yufish87/LiDAR-based_Illegal_Parking_Detection_AMR/reference/navigation_investigation/README.md

# 室外導航調查的旁支快照

這五個檔案從原備份原樣複製，只供與六入口主流程比較；不是新增的正式啟動流程。`root_` 前綴表示來源是原 ntust 根目錄。`frames.gv` 的取得時間與背景未知。來源及 SHA-256 見 [複製清單](../../docs/copied_files_manifest.json)，分析見 [調查報告](../../docs/室外導航無法移動_調查報告.md)。
