yufish87/LiDAR-based_Illegal_Parking_Detection_AMR/docs/整理與檢查結果.md

# 整理與檢查結果

日期：2026-09-23。本次只準備本地 `github/` 目錄，未建立 Git repository、提交或上傳；原資料夾的程式與資源保留。

原車已拆除。此次另納入使用者說明的實車調校背景，以及點雲約 3.75 Hz、辨識平均高於 1 Hz 的歷史回憶；精確辨識值與量測日誌未留存。無法補測的項目改列歷史資料缺口，不要求以原車重測才能交付文件。

## 已完成

- 複製 2,694 個來源檔案（含 Mega sketch、尺寸原圖、室外導航調查的 5 個旁支快照及 IMU 查核的 3 個旁支檔案），涵蓋主控制、定位、光達、感知、禁停、相機、資源及報告。
- 新增 README、安裝／設定／驗證說明、依賴分組、來源與授權狀態、Git LFS 規則、Issue／PR 範本和手動靜態檢查流程。
- 已核對複製清單的來源與複本 SHA-256。相機部署網址外部化，以及架構／控制報告／缺漏文件更新為刻意變更；控制程式與新收錄韌體原樣保留。
- 32 個資源（含第三方測試資源）的 SHA-256 均通過；地圖、STL、權重、尺寸圖與前次 PDF 已在本地備妥。此次資訊更新以 Markdown 為準，未重製 PDF。
- 已新增使用者提供的辨識 YAML 與原廠硬體查核文件。前次已核對 12 項參數的結構、名稱、型別和值，以及當時 95 個文件本地連結；10 個主控制／辨識／韌體檔案的雜湊與來源一致。YAML 為單純數值與布林 mapping，採靜態格式核對，未在 ROS 執行載入。

## 靜態檢查結果

後續資訊更新已確認編碼器 1000 線、驅動器 1600 細分。文件補入 A 雙邊緣計數的條件式推算及 ppr=1600 待核對事項；此次另將使用者提供的辨識參數存為 config/vehicle_detector.yaml；未改動原控制／辨識程式預設、導航 YAML 或韌體，也未執行硬體測試。

檢查 612 個 Python、10 個 ROS package XML、1 個 URDF、8 個 console-script 入口、91 個 CMake 安裝程式路徑及 34 個 CUDA extension source 宣告。XML／URDF 解析及本次檢查涵蓋的 CMake／CUDA 檔案存在性檢查通過。

整體靜態檢查**未通過**，保留 5 項原始問題：辨識 launch 與 KITTI 評估工具各一處 Python 語法錯誤；兩個自製 ROS 入口及一個 SDK Python 入口找不到對應模組。詳見 [缺漏清單](檔案缺漏與待確認事項.md) 與 [機器可讀結果](static_audit.json)。沒有為取得成功狀態而隱藏這些問題。

使用者已確認 ROS 2 Foxy／Ubuntu 20.04，README 與安裝指引已改用該基線。主機已確認為 AGX Xavier，馬達型號已從原報告及原廠核對，14 mm 為輸出軸直徑；STL 原點為 O、圖右為 +x。現有 footprint 軸向不符已記錄，原廠配套驅動器手冊已找到但實車型號未確認。NDT 函式庫匯出、其他版本來源在 Foxy 的相容性、固定路徑和 TF／地圖一致性仍屬後續建置與部署核對事項，未被上述語法檢查證實通過或失敗。

## 未執行

目前在 Windows 進行檔案整理，沒有執行 Linux ROS／colcon 建置、shell 執行驗證、GPU 模型載入、Arduino 編譯／燒錄、Mega 通訊、相機上傳或實車導航。安裝文件是依原始碼及官方文件整理的操作指引，仍需在確定的 Jetson 環境完成驗證。

發布前必要補件見 [開源專案完整性清單](開源專案完整性清單.md)，收錄範圍見 [檔案收錄說明](檔案收錄說明.md)。

本輪文件更新已核對 110 個本地連結，更新三份複製文件的 SHA-256；兩套地圖 YAML／PGM 與 map.sh、nav1.sh 共六檔均與原來源雜湊一致。先前參數與程式檢查結果保留，未重跑 ROS 或硬體測試。

## 室外導航調查補充

新增 [調查報告](室外導航無法移動_調查報告.md) 與 [分析結果](navigation_investigation.json)。核對官方 Foxy 的地圖引數、QoS 參數覆寫、Map Server 發布與 StaticLayer 接收機制；完整解析兩張 PGM 與兩份 PCD 的 XYZ，資料列數均與 PCD header 相符。另確認主腳本所指 Ouster sensor.launch.xml 在目前備份未找到。控制程式、YAML、地圖及韌體未修改；所有根因結論保留歷史日誌與原安裝版本不足的限制。

本次最終核對 2,691 個複製檔案的雜湊與大小、125 個文件本地連結及 13 組主控制／地圖原檔與複本，均相符。另以官方 RewrittenYaml 的原始 helper 方法進行隔離執行，驗證代表性 StaticLayer mapping 會從 True 被覆寫為 False；未啟動 ROS 或 DDS。既有靜態程式檢查的 5 項問題保留。

## 啟動順序紀錄補充與判斷修正

已閱讀並核對 [fish/ros2_ws/run.md](../fish/ros2_ws/run.md)，其中 Nav2 → nav_gui → map.sh 的順序使「地圖先發布、導航後加入」缺乏直接支持，QoS 嫌疑已降為備選。README 先前自行排列的建議順序改為有來源的歷史順序；報告、架構、設定、缺漏與分析 JSON 已同步修正。使用者確認兩檔確實為不同場地的圖，此事不再僅列推測。原 run.md 與控制程式未修改。

此補充已驗證 run.md 的原檔、複本與既有清單雜湊相符，核對第 15／17／19 行順序；更新三份複製文件雜湊，檢查 137 個本地文件連結及七份啟動／設定檔的原檔與複本一致性，均通過。未重跑 ROS 或硬體測試。

## 2026-09-24 里程計與 IMU 查核

新增三題答覆與三份未修改的旁支參考，更新架構及缺漏說明。三份新複本均以原始位元組複製並登錄 SHA-256，兩份更新的複製文件已同步雜湊。既有 preparation_audit.json 保留前次檢查快照，本次未重跑完整檢查、ROS 或硬體測試。

## 2026-09-24 GitHub 資料夾完整性複查

- 已重新核對 2,694 個複製檔案的存在、大小及 SHA-256，並比對原備份來源；沒有漏複製、內容不符或重複目的地。
- 主控制入口、Mega 韌體、定位／光達套件、辨識／違停／相機程式、兩套 YAML／PGM、兩份 PCD、STL、權重、模型設定、zones 與實車辨識 YAML 均已收錄。
- README、安裝／設定／驗證、架構／硬體／報告、啟動紀錄、缺漏清單、來源與授權狀態、依賴分組及 GitHub 範本均存在。缺漏清單正式保留，README 已加入收錄狀態與限制說明。
- 重新執行既有靜態檢查及 32 個資源的 checksum 校驗；資源全數通過，程式仍有相同 5 項原始問題，沒有新增錯誤。
- 文件內本地連結檢查通過；未混入建置產物或巢狀 Git 目錄。完整數量與結果見 [preparation_audit.json](preparation_audit.json)。

可取得的主要備份已收錄；Ouster 確切部署入口、GAS 接收端及違停目標轉 Nav2 接收端等既有缺口仍明列。整體 LICENSE、來源／發布範圍與原機版本紀錄尚待確認，不能宣稱本資料夾已能直接完整重建。此次未修改控制程式、執行 ROS／硬體測試或上傳 GitHub。
