yufish87/LiDAR-based_Illegal_Parking_Detection_AMR/docs/檔案缺漏與待確認事項.md

# 檔案缺漏與待確認事項

最新更新：2026-09-24，已納入拆車現況、實車調校背景、近似效能回報、IMU 查核，以及已確認有室內／室外地圖與室外無法移動的調查。既有硬體、座標、辨識參數與原廠查核結果一併保留。疑問集中記錄；不推定缺檔一定由 Google Drive 下載造成。

## 拆車後的整理原則

車輛已拆除，許多實際量測與接線資訊無法補全。使用者說明大部分程式參數曾按實車狀況調整，故保留原部署值，不僅因與標稱尺寸不同就認定錯誤。個別校正過程、倍率及靜態幾何差異仍如實註記，不宣稱全部已驗證。無法補測的項目列為歷史資料缺口，不再反覆要求補件，也不阻止完成報告與歷史程式整理。

## 已釐清，不必再補問

| 項目 | 更新結果 |
|---|---|
| Mega 韌體 | 已找到並收錄 final_copy_20260923083515.ino，見 [firmware](../firmware/README.md)。 |
| 脈衝來源 | 使用者確認閉環步進編碼器；韌體由左右編碼器 A/B 中斷取得計數，再回傳 Jetson。 |
| /odom 與 IMU 設定 | 橋接程式已有編碼器里程計 `/odom` 與 `odom → base_link`。Ouster 驅動設定含 IMU，但主要 NDT 部署設定關閉 IMU 使用／預積分；詳見 [三題答覆](AMR里程計_IMU與控制架構答覆.md)。 |
| 編碼器與細分 | 馬達內建 1000 線編碼器，獨立型號未查得；驅動器設定 1600 細分。原廠介面資料已找到；每輪有效計數的實測紀錄未留存，原車已無法補測。 |
| 信心門檻 | 原始碼預設 0.1；實車四項門檻皆手動設為 0.4。指令已收錄至 [CONFIGURATION](CONFIGURATION.md)，完整提供的 YAML 已存為 [vehicle_detector.yaml](../config/vehicle_detector.yaml)，不再列缺件。 |
| 辨識追蹤 | 使用者確認採累積命中 5 次，非嚴格連續 5 幀。 |
| 違停參數 | 使用者確認目前程式的說明：軌跡匹配 1.2 m；另有 2 m 重複事件抑制。 |
| 辨識座標 | 輸出沿用點雲 frame_id，後續 TF 轉 map；sync_time_stamp=true 會將 stamp 改為 callback 當下時間。target_frame 並未自動轉換整批點雲。 |
| 實車環境 | Jetson AGX Xavier、ROS 2 Foxy、Ubuntu 20.04，使用者已確認，不再列為待補。 |
| 光達型號 | 原專題 PDF 第 8／15 頁分別記載 Ouster OS1／OS1 32s；保留報告記法，不再列為完全未知。 |
| 馬達補充 | 原報告型號 JMC 86J18156EC-1000-LS-01；14 mm 為輸出軸直徑，已與同型號原廠圖面核對。 |
| 車輪與原點 | 驅動輪 10 英吋；車體與 STL 原點皆為兩驅動輪觸地連線中點 O，圖右側為前進／+x。尺寸圖已收錄。 |
| 舊辨識 launch 的用途 | 使用者說明為筆電缺 odom 時另建的測試內容，搬程式到實車後未清除；不視為主要實車定位流程。 |
| 實際效能 | 依使用者回憶，點雲 topic 發布約 3.75 Hz，辨識平均高於 1 Hz；精確辨識值記不清約為 1 或 1.5 Hz，不寫成確定 1.5 Hz。原始日誌與條件紀錄尚未取得。 |
| 參數調校 | 使用者說明大部分程式參數曾依實車情況校正；保留部署值，個別校正紀錄缺失不等於已證明參數錯誤。 |
| 啟動順序 | 已找到 [fish/ros2_ws/run.md](../fish/ros2_ws/run.md)：nav1.sh 第 15 行、nav_gui.py 第 17 行、map.sh 第 19 行，導航先於地圖。原操作紀錄已存在 GitHub 複本，未改內容；各節點就緒時間仍未留存。 |
| 兩套地圖 | 使用者確認兩個檔名確實對應不同場地，兩份 YAML／PGM 均存在；何者屬室內／室外尚未明示。官方 Foxy navigation_launch 不使用 map 引數，不能據此推定 RViz／導航吃不同圖。 |

詳細腳位、協定、尺寸與程式依據見 [硬體與韌體](硬體與韌體.md)；官方圖面與手冊見 [馬達與驅動器資料查核](馬達與驅動器資料查核.md)。已找到原廠接線參考，仍不能憑配套頁確認實車驅動板型號。

## 無法補測的歷史資料缺口

| 項目 | 未留存／無法核實的資訊 | 保存方式與限制 |
|---|---|---|
| 編碼器倍率 | 已確認馬達內建；馬達至車輪傳動比、Mega 取樣接法／是否分頻，以及每輪一圈計數紀錄未齊 | 已知 1000 線。若 A 相每編碼器軸圈 1000 週期、訊號未分頻，現有 A 雙邊緣計數理論為 2000 次／軸圈；輪圈倍率為 2000 × 傳動比。1:1 等假設下的 25% 差異僅為推算，不能當成歷史實測誤差；保留 ppr=1600，供未來重建者校正。 |
| 幾何校正 | 實測輪距、有效滾動直徑與個別校正過程，以及 footprint 差異的部署說明 | 前進 +x 與 STL 原點已確認。現有 footprint 與尺寸圖的軸向不一致，參考修正值已列硬體文件；輪徑 254／260 mm、輪距 850／820 mm 分別保留為標稱／部署／模型數值，不逕自改值；個別校正歷程無法補測。902 mm 為外框寬。 |
| 硬體接線 | 實車驅動板型號／後綴、編碼器分接 Mega 的接法、供電／電流設定、停止及警報線路 | 官方配套候選 2HSS86H-A 的端子、接法與 1600 撥碼表已找到；尚不能確認實車就是該版本。馬達端編碼器 pinout 已有，Mega 的差動接收／轉接方式未記錄。 |
| 環境相依版本 | JetPack／L4T／CUDA、Python／PyTorch／spconv，以及原機 ROS 套件版本 | 主機已定為 AGX Xavier，系統為 Foxy／20.04，README 安裝指引已同步；備份內其他分支能否在 Foxy 重建仍需驗證。 |
| 韌體重建 | Arduino IDE／AVR Boards／AccelStepper 版本、燒錄紀錄 | 原始碼已補齊，本次未編譯或與板上 binary 比對。 |
| IMU 歷史使用與錄製 | 故障當次是否發布 IMU、旁支是否運行，以及本車 IMU bag／錄包紀錄 | 保存設定不啟用 IMU 定位融合；另有時間戳處理程式但不錄包，也不在主啟動紀錄。未找到足以確認本車 IMU 錄製的資料，保留未知。 |
| 效能量測 | 回憶中的點雲約 3.75 Hz、辨識平均高於 1 Hz；未留存精確平均、時間窗、延遲／負載及其餘節點實測 | 見 [歷史實車測試紀錄](歷史實車測試紀錄.md)。此為近似運行概況，不能推定瓶頸或還原正式 benchmark；不要求拆車後補測。 |

環境及韌體版本若還有舊紀錄，可據此整理；無紀錄的部分保留未知。重建與新測試結果須另立版本，不當成原車歷史事實。

## 可由現存軟體繼續核對的項目

| 項目 | 現有證據與缺口 |
|---|---|
| 違停目標轉導航 | 找到 /violation/nav_target 的 PoseStamped 發布端，主要程式未找到相應 Nav2 action 接收端。若不包含自動靠近功能，可維持未接通狀態。 |
| GAS 接收端 | 相機上傳程式存在，尚未找到 Apps Script .gs 或 appsscript.json。需補接收端與部署／欄位說明；公開複本以 AMR_GAS_URL 取代固定網址。 |
| 光達規格 | 原報告已記載 OS1 32s；硬體修訂、韌體與原機網路／點雲 frame 紀錄仍待補。 |
| NDT 的實際版本 | local.sh 經安裝套件索引取 launch；根目錄、src、原 install 有差異。需選定能從 source 重建的版本，部署快照已放在 reference。 |
| 光達 TF | URDF 定義 base_link → os_lidar；定位 launch 另預設 base_link → os_sensor 零位移。需核對點雲 frame、真實安裝外參與啟用參數。 |
| NDT 速度預測 | use_twist_prediction=true 指向 /twist，主橋接發布的是 /odom，未找到主流程的 /twist 發布端。 |
| 地圖場景與基準 | 已確認有室內／室外地圖。離線解析支持 mymap ↔ cloudGlobal 與 my_map ↔ final_map...FLATTENED 兩組範圍配對，zones.yaml 亦使用前者基準；這不是精確配準或歷史場景證明。主流程 Map Server 與部署 NDT 快照目前均選大圖組，不能僅由 nav1.sh 的無效 map 引數推定混圖。見 [室外導航調查](室外導航無法移動_調查報告.md)。 |
| Ouster 版本 | 收錄兩個候選，ros2 v0.15.0 與 ros2-foxy v0.12.7；需選定實車版本，同一 ROS 環境只啟用一套。 |
| 另一套底盤橋接 | 根目錄 motor_bridge.py 是不同協定方案，仍以使用者指定的 ros2_ws/odem_bridge.py 為主；不混用參數。 |

## 室外故障調查新增紀錄

- **降為備選的 QoS 問題**：官方 Foxy navigation_launch 將 map_subscribe_transient_local 預設覆寫為 false；但 run.md 記錄導航先、地圖後，不支持直接假設晚加入。設定覆寫仍成立，故保留為重建／重啟時的查核項目，不再列首要歷史嫌疑。
- **Ouster 啟動檔缺口**：主腳本指定 sensor.launch.xml，但備份中未找到確切檔名；有 sensor.composite.launch.xml 等候選，可能為安裝檔／連結未備份或版本差異。當時曾有點雲回報，不能回推當時驅動必定失敗。
- **歷史證據缺口**：操作順序已由 run.md 補足；仍未找到故障當次各節點就緒／重啟時間及執行日誌、實際 Nav2 安裝 launch／版本、有效參數、TF／cmd_vel 錄製與 RViz 設定。建置日誌和第三方 sample bag 不替代實車紀錄。
- **其他設定差異**：定位 PCD 尾端覆寫、工作目錄影響 overlay／URDF、零初始位姿、光達 TF、footprint，以及 Foxy 單數 goal_checker_plugin 與現有複數設定差異，均已分級說明。原控制檔保留。

詳細證據、候選修正命令與查核順序見 [室外導航調查](室外導航無法移動_調查報告.md)。無法補測的項目維持歷史缺口，不要求重新組車。

## 已知程式問題與檢查方向

以下保留靜態分析結果，未修改控制或辨識程式。涉及硬體量測的檢查方向供未來重建參考，並非要求原車補測。

| 項目 | 狀態與影響 |
|---|---|
| Footprint 軸向 | 已確認 STL 原點為 O、車頭為 +x；現有 Nav2 外框長邊沿 y，與尺寸圖不一致。幾何參考值已寫入硬體文件，導航 YAML 本次未修改。 |
| 辨識 launch 語法 | 三段舊 Node 的宣告已註解，但其 parameters 字典內容與結尾仍留在程式中；第 72 行附近先被 AST 偵測。來源用途已釐清，語法問題仍存在。後續應整理筆電測試殘留。 |
| 兩個自製 console entry points | setup.py 仍宣告 map_server_node、localizer_node，但模組不存在。依本次說明可列為舊測試入口待清理，而非預設必須找回的實車主功能。 |
| KITTI 評估工具 | OpenPCDet 的 kitti_object_eval_python/evaluate.py 第 5 行 import .kitti_common as kitti 無效；屬 KITTI 評估，尚無證據表明主 nuScenes 推論必經此檔。 |
| Ouster SDK Python 入口 | 新版 SDK setup.py 指向 ouster.sdk.simple_viz，對應模組未找到。需核對 SDK 封裝版本；不等於 ROS C++ 驅動已證實失效。 |
| NDT 函式庫匯出 | ndt_omp_ros2 建立 ndt_omp，但安裝／匯出不完整的疑點待確認；下游有引用。未進行乾淨建置，不宣稱已實測編譯失敗。 |
| local-prefix 架構 | 定位環境腳本含 x86_64 路徑，需確認 Jetson ARM64 前綴。 |
| GPU 依賴 | NumPy 體素化備援不等於完全不需 spconv；版本組合與 OpenPCDet 來源 commit 尚待補。 |
| 序列與迴圈時序 | Mega parseFloat 可能阻塞主迴圈；Jetson 非阻塞 readline 未暫存半行。先測量丟行與延遲，不能僅靠提高 timer 頻率改善。 |
| 辨識時間戳 | sync_time_stamp=true 在 callback 開始重寫 stamp；辨識結果保留重寫時間。量測端到端延遲需另外保留原始感測時間，不以此參數宣稱已完成時鐘同步。 |
| 回授一致性與停止 | Mega 傳送 volatile long 時未取受保護的快照；500 ms 指令逾時分支存在，但阻塞、加減速及實車停止時間尚未驗證。 |

[靜態檢查結果](static_audit.json) 目前仍有 5 項原始錯誤（2 處語法、3 個不存在的入口模組），不因用途已釐清就改報成功。韌體的新分析是閱讀結果，不包含 Arduino 編譯測試。

## 發布前文件與資源

- 地圖、STL、權重、Mega sketch 及尺寸圖已存在，不再列為缺檔；資源檔校驗不等於載入與實車測試。
- 需補整體 LICENSE、作者／維護者、權重來源、地圖／CAD／報告發布範圍，以及正式 repository URL。
- 此次以 Markdown 為最新報告來源；既有 PDF 保留先前版本，未同步本次硬體與實車補充，不能將其當成最新定稿。
- 其餘發布待辦見 [開源專案完整性清單](開源專案完整性清單.md)。
