yufish87/LiDAR-based_Illegal_Parking_Detection_AMR/docs/開源專案完整性清單.md

# 開源專案完整性清單

依現有 AMR 程式與先前查核的 GitHub／ROS／NVIDIA 官方文件整理，檔案複查日期 2026-09-24。本次產出是可供團隊審查的本地準備目錄，未建立或上傳遠端 repository。

原車已拆除，本次發布定位為「歷史程式與設計紀錄」。無法補測的尺寸、接線及性能資料明列缺口，不要求重新組車才能完成文件交付。軟體建置、授權與來源整理仍可由現存資料處理；若未來要宣稱新版本可完整重現，再完成對應驗證。

## 已備妥

- [x] Mega sketch 與車底尺寸圖已收錄；AGX Xavier、馬達型號／軸徑、STL 原點與前進軸已確認。
- [x] 四項 0.4 門檻指令與 [辨識 YAML](../config/vehicle_detector.yaml) 已保存；原廠馬達圖面、配套候選驅動器接線手冊已找到。
- [x] README：目的、架構、硬體、目錄、依賴與安裝入口、啟動、驗證、授權與已知限制。
- [x] 主流程 source、設定、第三方 source 與原 LICENSE；地圖、STL、權重及既有報告已複製。
- [x] 安裝／設定／驗證文件；Python 依賴分組與原機版本蒐集工具。
- [x] `.gitignore`、文字行尾設定及大型資源的 Git LFS patterns。
- [x] 檔案來源、checksum、上游 commit／branch、可取得的本地修改差異。
- [x] 缺漏與疑問集中記錄；原根目錄程式未修改。
- [x] 原始 run.md、里程計／IMU 答覆、室外故障調查與部署參考已收錄；[缺漏與待確認清單](檔案缺漏與待確認事項.md) 隨專案保留並由 README 連結。
- [x] CONTRIBUTING、Issue／PR 範本與手動靜態 CI。
- [x] 相機公開複本不再內嵌原 GAS 部署網址，改用環境變數。

## 歷史資料缺口與未來重建條件

| 優先項 | 目前缺口 | 完成標準 |
|---|---|---|
| 硬體端 | 已有 Mega source、1000 線編碼器資訊及 1600 細分；編碼器內建於馬達；配套候選手冊已有，實車驅動板型號、編碼器至 Mega 接法、傳動比與每輪有效計數待補 | 原車已拆除，無法找回的部分明列歷史缺口；未來重建時再記錄新硬體接線、回授倍率與停止測試。 |
| 環境基線 | 已確認 AGX Xavier／Ubuntu 20.04／ROS 2 Foxy；JetPack 及各套件精確版本待補，備份另有 Humble 文件 | 依已確認基線補齊 JetPack、Python、GPU 與 ROS 套件版本，驗證收錄來源在 Foxy 的相容性。 |
| Source 可建置 | 辨識 launch 語法、缺失 entry point 模組、NDT 函式庫匯出疑點 | 乾淨環境 colcon build 與模型載入成功，結果有紀錄。 |
| 組態可移植 | 絕對路徑、已確認不同場地的兩套地圖、多個 TF 版本、footprint 軸向差異；0.4 參數已保存 | 保留兩套地圖，不直接統一成單一檔案；室內／室外逐檔對應未明示，重建時按場景選擇地圖／PCD／zones，並設定 launch／參數入口及外參。 |
| 光達部署入口 | 主 lidar.sh 指定的 sensor.launch.xml 確切檔名未在備份找到，已有其他 launch 候選 | 核對原部署版本或在重建時明確選用相容入口；不以相似檔名冒充原檔。 |
| 依賴可重現 | requirements 未鎖版、OpenPCDet commit 未知 | 依原機收集版本並產出驗證過的 lock／容器配方或等效紀錄。 |
| 雲端與任務介面 | GAS source 未找到、違停目標轉導航未找到 | 若列為已完成功能，需補接收端及端到端驗證；否則維持選用／未完成狀態。 |
| 授權 | 整體 LICENSE、作者與部分資源再散布條件未確認 | 團隊選定 LICENSE，保留第三方聲明，確認報告／地圖／CAD／權重的發布範圍。 |
| 大型資源 | PCD 超過一般 Git 單檔大小限制 | 在第一次 add 前啟用 LFS；公開後從全新 clone 驗證下載與 checksum。 |
| 歷史效能與重建驗證 | 回憶中的點雲發布約 3.75 Hz、辨識平均高於 1 Hz，無完整原始日誌 | 歷史版標明近似數值與來源即可；未來重建版另做路徑、辨識樣本及頻率／延遲驗證，不能回填為原車實測。 |
| 專案身份 | 遠端 URL、維護者未指定 | 填寫真實維護者、版本號、聯絡方式、正式 repo URL。 |

## 建議後續改善

- 以一個 ROS bringup package 統一啟動，避免多個 shell 腳本依賴工作目錄與舊帳號路徑。
- 自製套件補齊 package.xml runtime dependencies，取代僅存在於文件的手動依賴。
- 新增小型、可公開的 rosbag／點雲範例及無馬達模式，讓沒有實車的人也能重現感知結果。
- 確認硬體支持後加入有意義的 ROS integration tests，再把手動 CI 擴成 PR 檢查。
- 首次可重現版本提供 release notes、CHANGELOG、圖像或演示影片；不提前放「passing」或已選定授權的徽章。
- 若有學術引用需求再加入正確作者資訊的 CITATION.cff；如需多人協作，再設定 CODEOWNERS／行為準則與維護流程。

## 查核依據

GitHub 的 README 應讓讀者知道專案用途與如何開始；貢獻規範用獨立文件承接。[GitHub 專案溝通文件](https://docs.github.com/en/issues/tracking-your-work-with-issues/learning-about-issues/planning-and-tracking-work-for-your-team-or-project)

授權需有明確可讀的 LICENSE，不能只因 repository 公開就假定可自由使用。[GitHub 授權文件](https://docs.github.com/en/communities/setting-up-your-project-for-healthy-contributions/adding-a-license-to-a-repository)

GitHub 一般 Git 不接受超過 100 MiB 的單檔；本案地圖實際超過限制，因此準備 Git LFS。[GitHub 大型檔案文件](https://docs.github.com/en/repositories/working-with-files/managing-large-files/about-large-files-on-github)

ROS workspace 的標準建置與 overlay 載入方式，參照 [colcon 官方教學](https://github.com/ros2/ros2_documentation/blob/humble/source/Tutorials/Beginner-Client-Libraries/Colcon-Tutorial.rst)；Jetson 的 PyTorch 則以 [NVIDIA 相容安裝指引](https://docs.nvidia.com/deeplearning/frameworks/install-pytorch-jetson-platform/index.html) 為準。本專案是否已支援某版本，仍以自己的建置／測試紀錄判定。
