yufish87/LiDAR-based_Illegal_Parking_Detection_AMR/docs/馬達與驅動器資料查核.md

# 馬達、內建編碼器與配套驅動器查核

查核日期：2026-09-23。資料來源為使用者補充、原專題 PDF 第 11–12 頁、JMC（杰美康）官方產品頁、圖面及手冊。原廠文件僅提供連結，不把整份手冊或圖面重新散布至專案。

## 已找到的馬達資料

原報告第 11 頁明列左右各一顆 **86J18156EC-1000-LS-01**，第 12 頁說明內建編碼器與閉環控制。JMC 有完整同型號的 [官方產品頁](https://www.jmc-motor.com/product/154.html)，並非只靠「86」或軸徑猜型號。

該頁連出的 [原廠圖面](https://www.szjmc.com/uploads/20220720/e2f3ed03875c76b60081831020f228e5.jpg) 標題欄同為 `86J18156EC-1000-LS-01`，可核對：

| 規格 | 圖面資料 | 本專案解讀 |
|---|---|---|
| 馬達形式 | 兩相，步距角 1.8° | 每圈 200 個整步；1600 命令脈衝／圈相當於每整步 8 細分。 |
| 外框／輸出軸 | 86 mm／Ø14 h6 | 使用者確認的 14 mm 是輸出軸直徑。 |
| 額定相電流／保持轉矩 | 6.0 A／12 N·m | 馬達規格；不代表已核實實車驅動器電流設定，保持轉矩也不等於行進中的輸出轉矩。 |
| 編碼器介面 | 5 V 電源，PA+/PA−、PB+/PB− | 已找到介面；圖面未提供內部編碼器的獨立廠牌／型號。 |

使用者確認編碼器為馬達內建、解析度 1000 線。獨立編碼器型號目前查無資料，可在報告記為「馬達內建 1000 線編碼器」，不用為此中斷整理。

## 驅動器找到配套候選，實車型號仍未確認

上述馬達官方頁將 **2HSS86H-A** 列為搭配產品；[驅動器官方頁](https://www.jmc-motor.com/product/170.html) 也列出支援 1000／2500 線編碼器。因此可以把它記為「原廠搭配候選」，但廠商附貨紀錄和板上銘牌目前皆未提供，不能直接寫成實車已確認型號。

已找到 [2HSS86H-A 英文手冊 V1.1](https://www.jmc-motor.com/uploads/20240730/2d86cdd099df7c071c1551a86bbbff48.pdf)：第 6 頁為控制／編碼器端子，第 9–11 頁為共陽、共陰與差動接法，第 14 頁為細分表，第 16–17 頁為編碼器計數方式及典型接線。對此候選版本，1600 對應 SW3=ON、SW4=OFF、SW5=ON、SW6=ON；這是命令脈衝／圈，並非編碼器計數。手冊中的驅動器內部四倍頻會把 1000 線解為 4000 計數／馬達圈，與 Mega 的 A 雙邊緣解碼不同。

原廠另有 [中文 V3.34 手冊（2HSS86H-A-XX）](https://szjmc.com/uploads/20220224/06750fe1d4f129414160718e1c79feab.pdf)；其電流規格與英文 V1.1 不同，部分接線圖還標示其他後綴。故電源、電流和電平配置須按實際板子版本核對，不將不同文件拼成實車規格。

## 可記錄的接線關係

以下對照馬達原廠圖面、候選驅動器手冊及本地韌體；它是介面索引，不是已量測完成的實車線路圖。

| 路段 | 可核對的介面 |
|---|---|
| Jetson → Mega | 本地程式：USB 序列通訊 115200 bps，`V線速度,角速度`。 |
| Mega → 驅動器 | 本地韌體：左 STEP/DIR 為 D6/D7、右為 D8/D9；候選驅動器對應 PLS（圖中亦寫 PUL）及 DIR 輸入對。共陽／共陰等實接形式未提供。 |
| 驅動器 → 馬達 | 馬達圖面：A+ 紅、A− 藍、B+ 綠、B− 黑，對應兩相繞組。 |
| 馬達編碼器 → 驅動器 | 馬達端 9-pin：1 GND、2 +5 V、3 PA+、4 PA−、5 PB+、6 PB−、7 屏蔽、8–9 NC；候選驅動器為相同名稱的編碼器輸入。兩端接頭編號不同，應按訊號名稱對照。 |
| 編碼器 → Mega | 韌體讀左 D2/D3、右 D20/D21；實際取樣點、差動接收／電平轉換及分接方式尚無記錄。 |

使用者確認驅動板依官方方式接線；原廠典型圖說明了馬達與驅動器的閉環，但沒有本專案另外分接 Mega 的線路。尤其 `PA/PB` 在此手冊是**編碼器輸入**，不可自行當成驅動器提供的編碼器輸出。這一段缺的是電氣接法，軟體上的 A/B → 計數 → 序列回傳 → odom 資料流已可追查。

## 歷史資料缺口

- 實際驅動板完整型號／後綴與版本，才能選定對應官方手冊。
- 編碼器至 Mega 的接法；左右輪各一圈的計數差與馬達至車輪傳動比。
- 實車供電、電流設定、ENA／ALM 使用方式及停止線路。

原車已拆除，以上資訊若無留存即記為歷史缺口，不要求補測。程式參數多曾依實車情況調整，保留當時部署值；未來重建時仍須確認有效輪圈計數。不能用驅動器內部 4000 計數，或命令端 1600 脈衝，代替 Mega 實際回報的計數。推算方式見 [硬體與韌體](硬體與韌體.md)，所有待辦集中於 [缺漏與待確認事項](檔案缺漏與待確認事項.md)。
