yufish87/LiDAR-based_Illegal_Parking_Detection_AMR/fish/ros2_ws/OpenPCDet/docs/demo.png

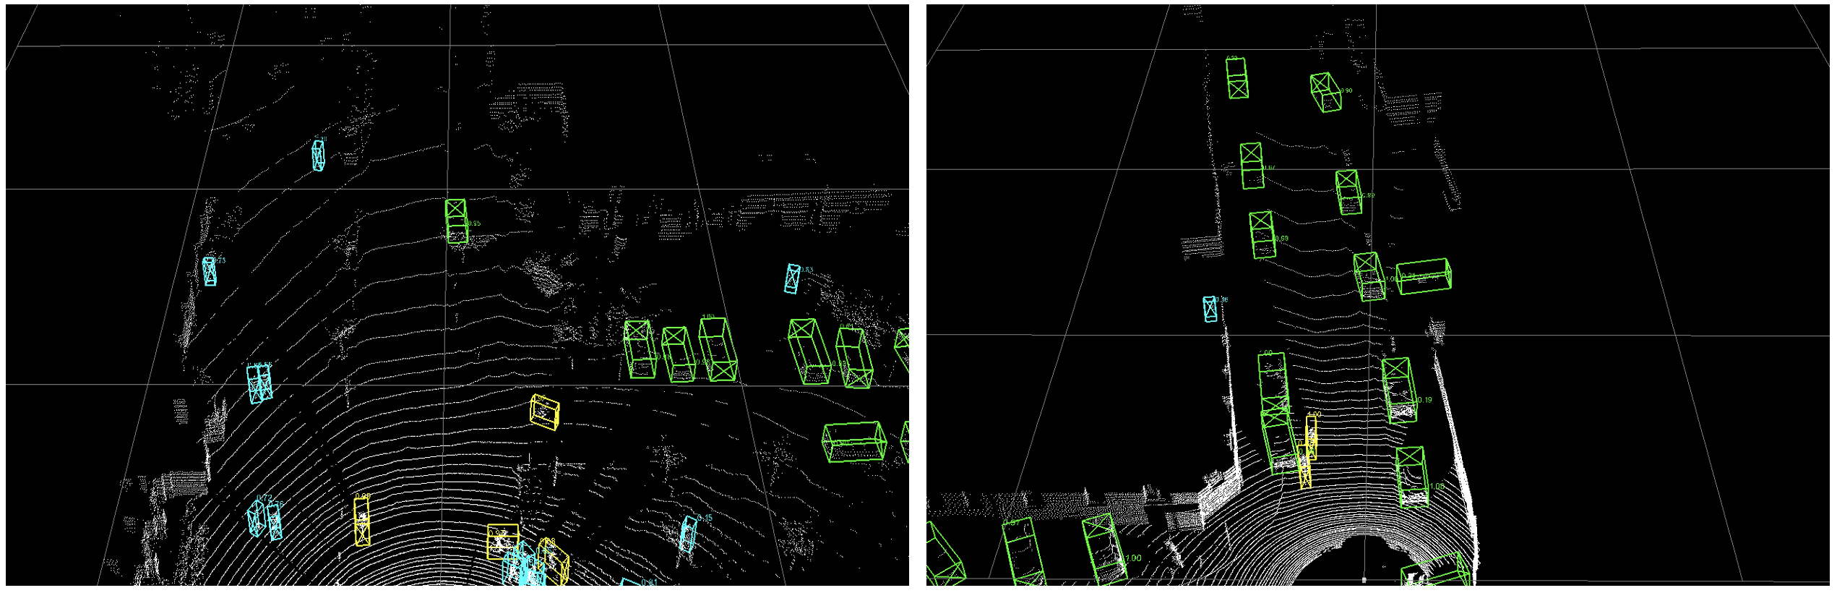
fish/ros2_ws/OpenPCDet/docs/demo.png
