yufish87/LiDAR-based_Illegal_Parking_Detection_AMR/fish/ros2_ws/OpenPCDet/docs/model_framework.png

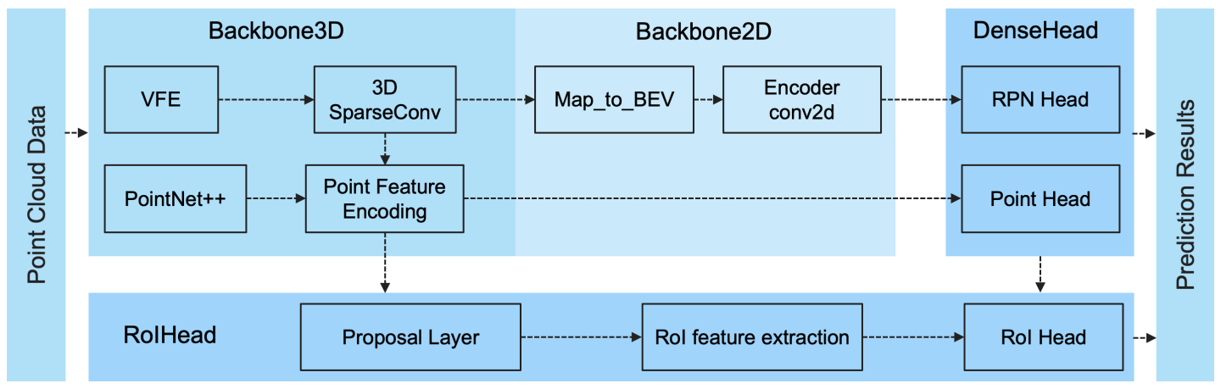
fish/ros2_ws/OpenPCDet/docs/model_framework.png
