yufish87/LiDAR-based_Illegal_Parking_Detection_AMR/ous/src/ouster-ros/ouster-ros/ouster-sdk/docs/images/brooklyn_bridge_ls_50_xyz_cut.png

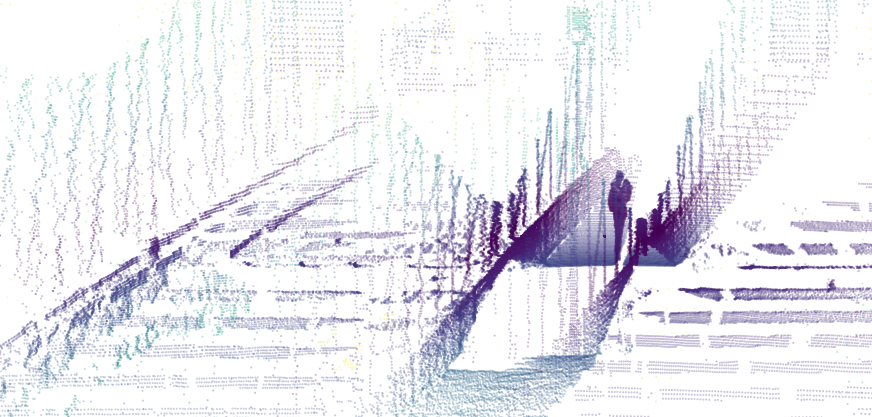
ous/src/ouster-ros/ouster-ros/ouster-sdk/docs/images/brooklyn_bridge_ls_50_xyz_cut.png
