yufish87/LiDAR-based_Illegal_Parking_Detection_AMR/ous/src/ouster-ros/ouster-ros/ouster-sdk/docs/images/lidar_scan_staggered.png

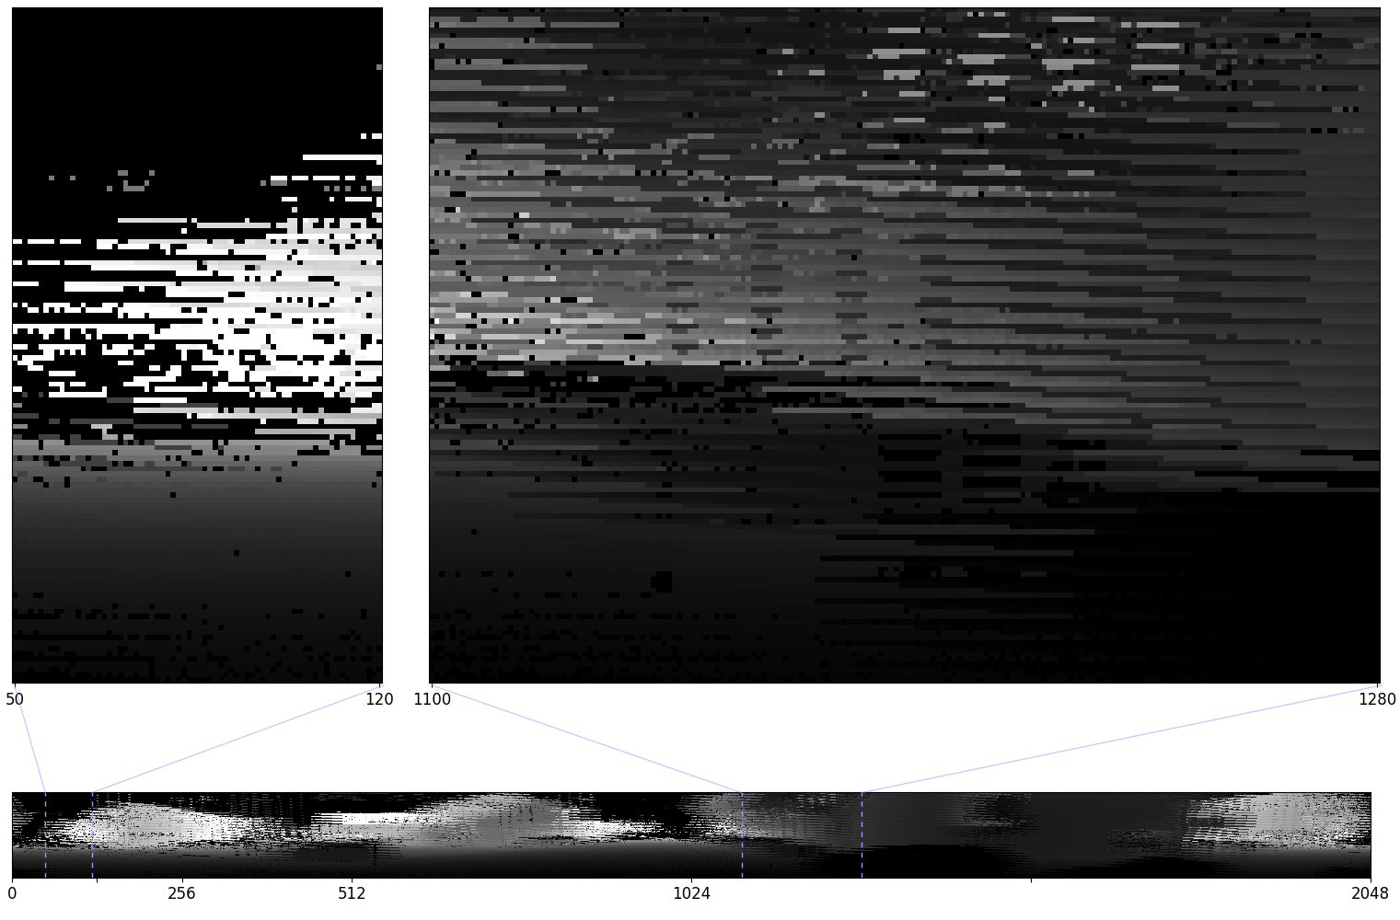
ous/src/ouster-ros/ouster-ros/ouster-sdk/docs/images/lidar_scan_staggered.png
