yufish87/LiDAR-based_Illegal_Parking_Detection_AMR/ous/src/ouster-ros/ouster-ros/ouster-sdk/docs/images/scans_accum_dense_every.png

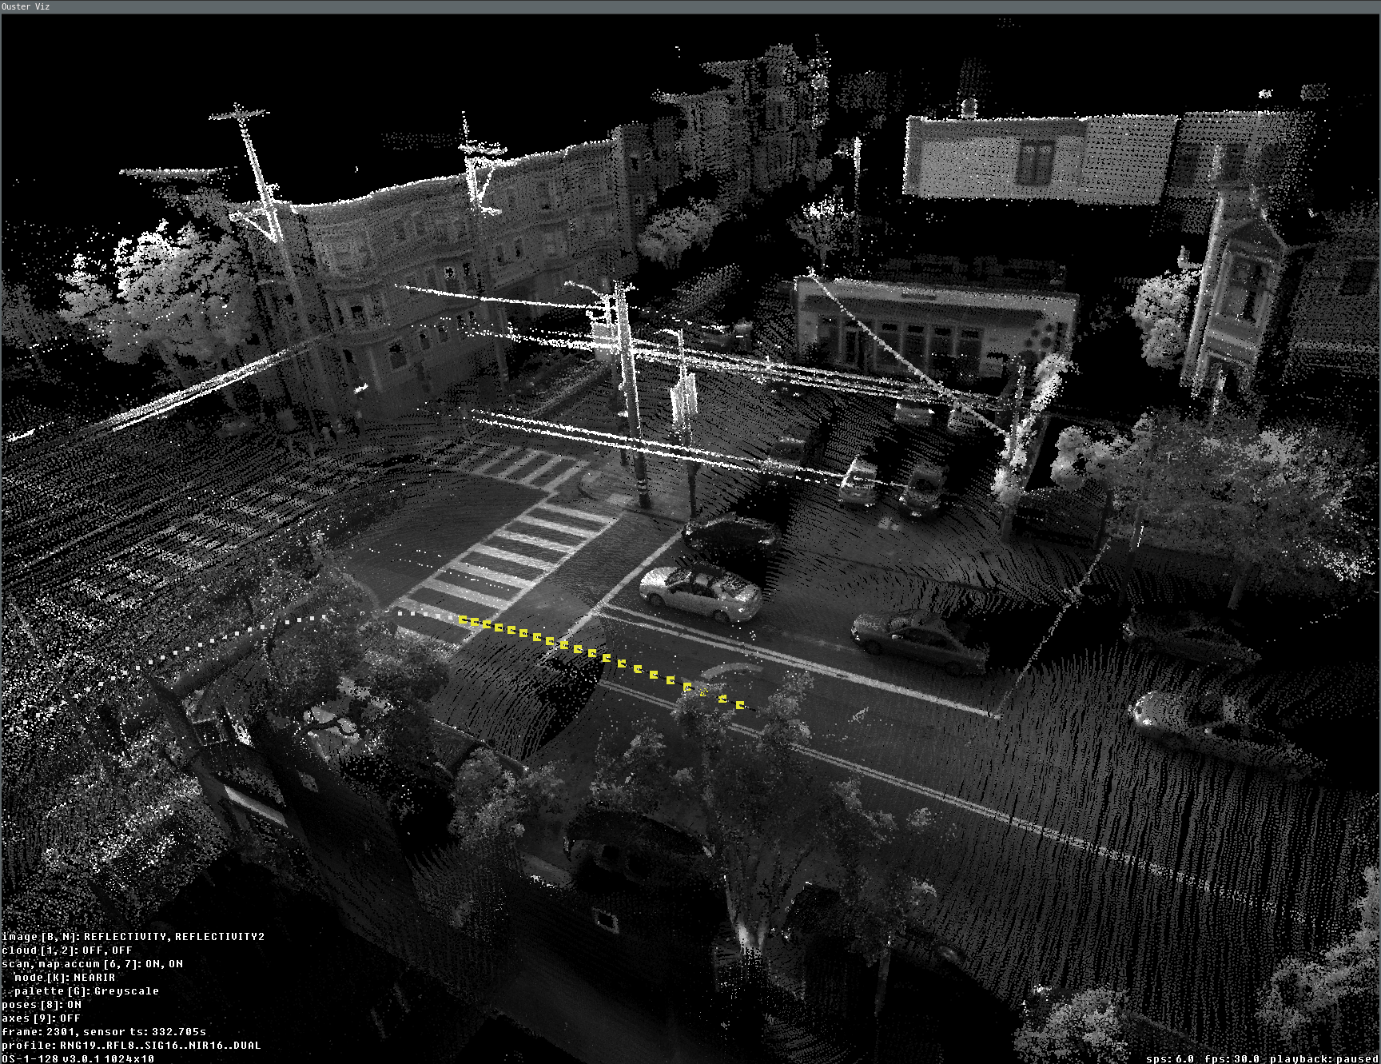
ous/src/ouster-ros/ouster-ros/ouster-sdk/docs/images/scans_accum_dense_every.png
