yufish87/LiDAR-based_Illegal_Parking_Detection_AMR/ros2_ws/src/lidar_localization_ros2/images/global_localization_demo.gif

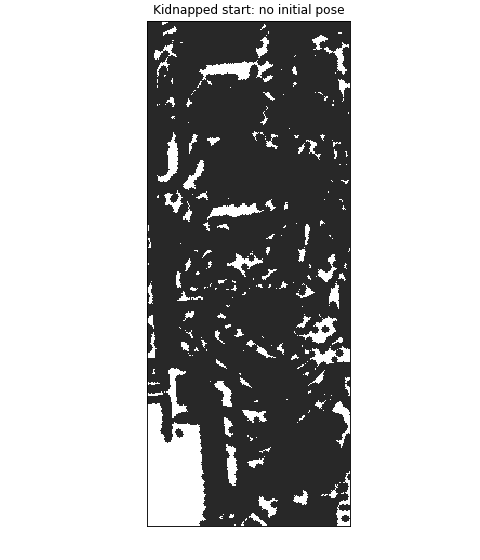
ros2_ws/src/lidar_localization_ros2/images/global_localization_demo.gif
