yufish87/LiDAR-based_Illegal_Parking_Detection_AMR/ros2_ws/src/lidar_localization_ros2/images/path.png

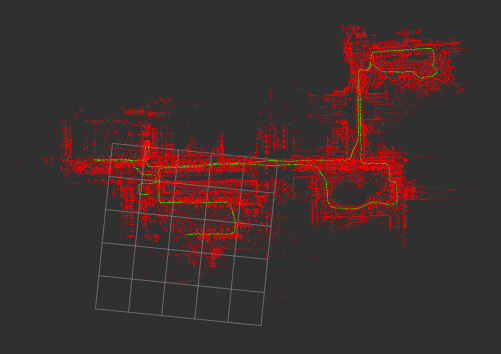
ros2_ws/src/lidar_localization_ros2/images/path.png
