yufish87/LiDAR-based_Illegal_Parking_Detection_AMR/ros2_ws/src/ndt_omp_ros2/data/screenshot.png

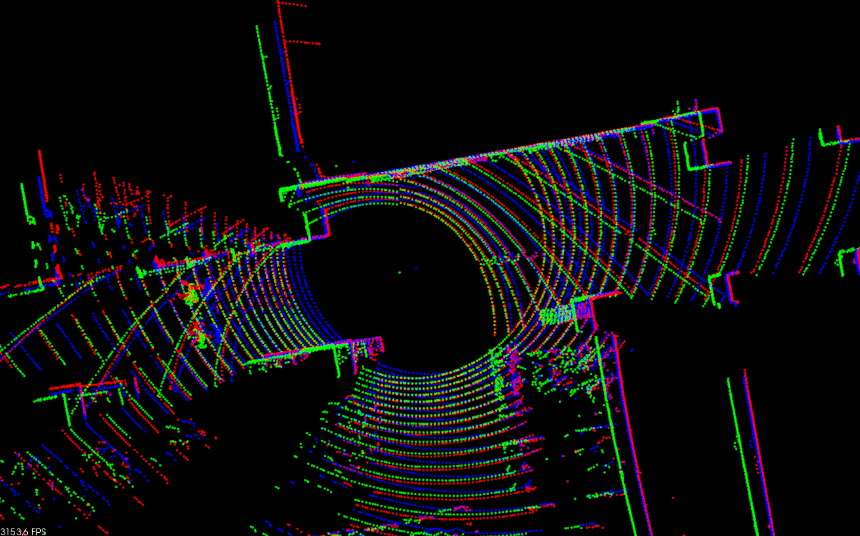
ros2_ws/src/ndt_omp_ros2/data/screenshot.png
