yufish87/LiDAR-based_Illegal_Parking_Detection_AMR/ros2_ws/src/ouster-ros/ouster-ros/ouster-sdk/docs/images/filter-example-z.png

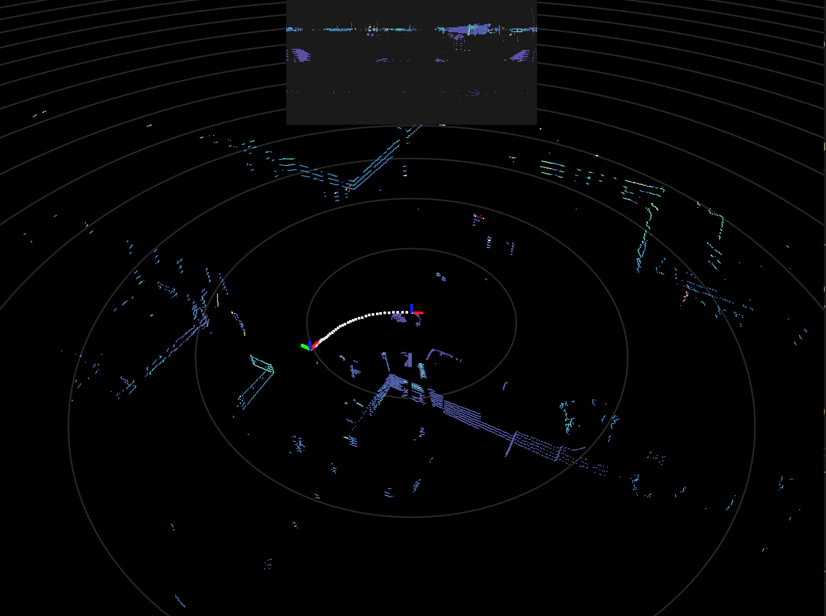
ros2_ws/src/ouster-ros/ouster-ros/ouster-sdk/docs/images/filter-example-z.png
