yufish87/LiDAR-based_Illegal_Parking_Detection_AMR/ros2_ws/src/pcd2pgm-main/.docs/pcd.png

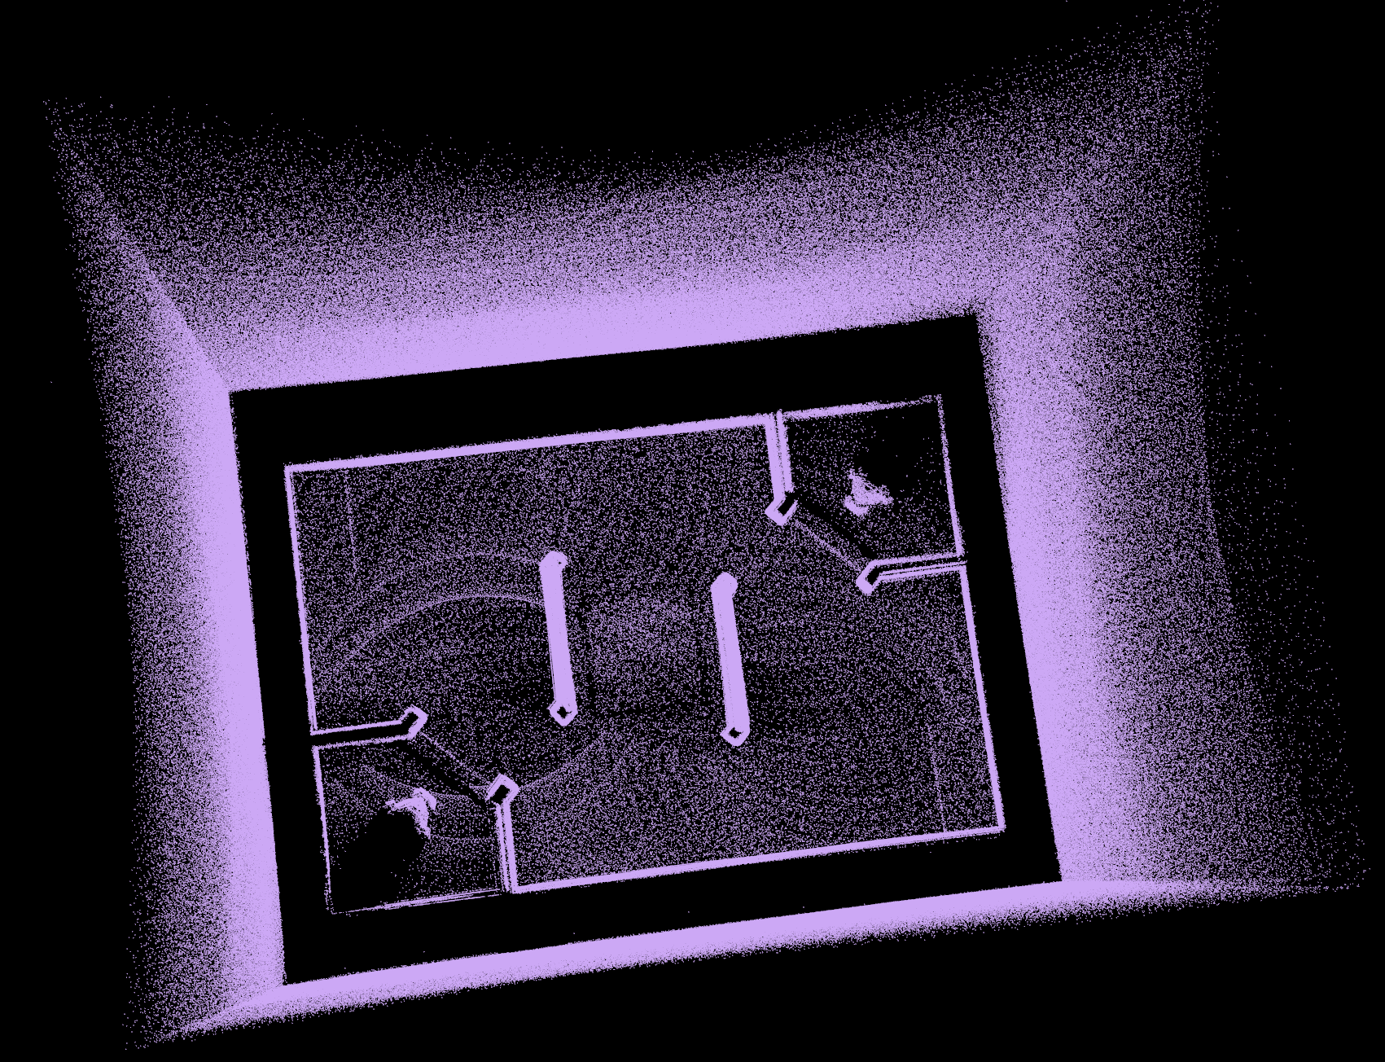
ros2_ws/src/pcd2pgm-main/.docs/pcd.png
