yufish87/LiDAR-based_Illegal_Parking_Detection_AMR/(list of files, cad)

Other CAD files:
agv.stl
ros2_ws/src/ouster-ros/ouster-ros/ouster-sdk/tests/clouds/cloud-ascii.ply
ros2_ws/src/ouster-ros/ouster-ros/ouster-sdk/tests/zone_monitor/ascii.stl
ros2_ws/src/ouster-ros/ouster-ros/ouster-sdk/tests/clouds/cloud-binary.ply
ros2_ws/src/ouster-ros/ouster-ros/ouster-sdk/tests/zone_monitor/4.stl
ros2_ws/src/ouster-ros/ouster-ros/ouster-sdk/tests/zone_monitor/5.stl
ros2_ws/src/ouster-ros/ouster-ros/ouster-sdk/tests/zone_monitor/3.stl
ros2_ws/src/ouster-ros/ouster-ros/ouster-sdk/tests/zone_monitor/ascii_invalid_expected_solid.stl
ros2_ws/src/ouster-ros/ouster-ros/ouster-sdk/tests/zone_monitor/ascii_invalid_expected_endsolid.stl
ros2_ws/src/ouster-ros/ouster-ros/ouster-sdk/tests/zone_monitor/ascii_invalid_expected_endloop.stl
ros2_ws/src/ouster-ros/ouster-ros/ouster-sdk/tests/zone_monitor/ascii_invalid_unexpected_line.stl
ros2_ws/src/ouster-ros/ouster-ros/ouster-sdk/tests/zone_monitor/empty.stl
ros2_ws/src/ouster-ros/ouster-ros/ouster-sdk/tests/zone_monitor/ascii_invalid_expected_endfacet.stl
ros2_ws/src/ouster-ros/ouster-ros/ouster-sdk/tests/zone_monitor/0.stl
ros2_ws/src/ouster-ros/ouster-ros/ouster-sdk/tests/zone_monitor/ascii_invalid_expected_vertex.stl
ros2_ws/src/ouster-ros/ouster-ros/ouster-sdk/tests/zone_monitor/tiny.stl
ros2_ws/src/ouster-ros/ouster-ros/ouster-sdk/tests/zone_monitor/ascii_invalid_expected_outer_loop.stl
ros2_ws/src/ouster-ros/ouster-ros/ouster-sdk/tests/zone_monitor/plane.stl
ros2_ws/src/ouster-ros/ouster-ros/ouster-sdk/tests/zone_monitor/1.stl
ros2_ws/src/ouster-ros/ouster-ros/ouster-sdk/tests/zone_monitor/2.stl
