yufish87/LiDAR-based_Illegal_Parking_Detection_AMR/ous/src/ouster-ros/ouster-ros/ouster-sdk/docs/images/viz-tutorial/axes_helper_unstructured.png

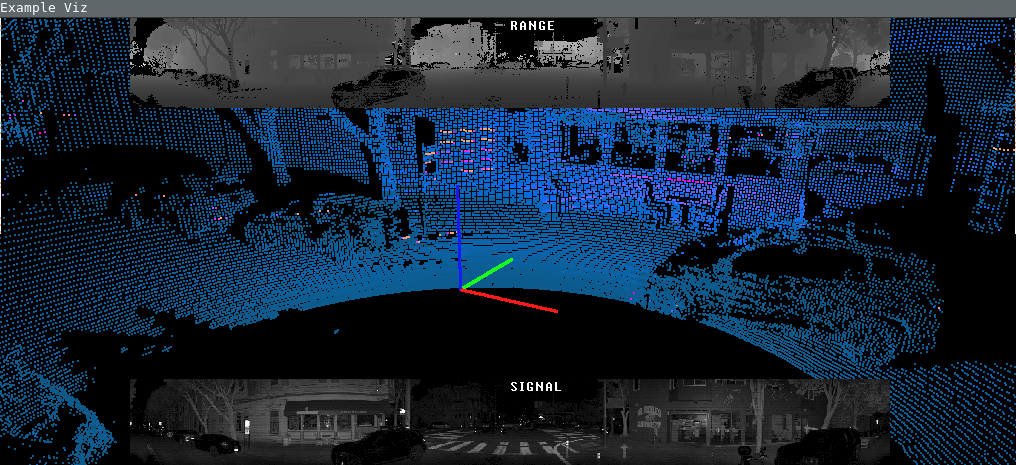
ous/src/ouster-ros/ouster-ros/ouster-sdk/docs/images/viz-tutorial/axes_helper_unstructured.png
