yufish87/LiDAR-based_Illegal_Parking_Detection_AMR/ous/src/ouster-ros/ouster-ros/ouster-sdk/docs/images/viz-tutorial/image_set_pos_center.png

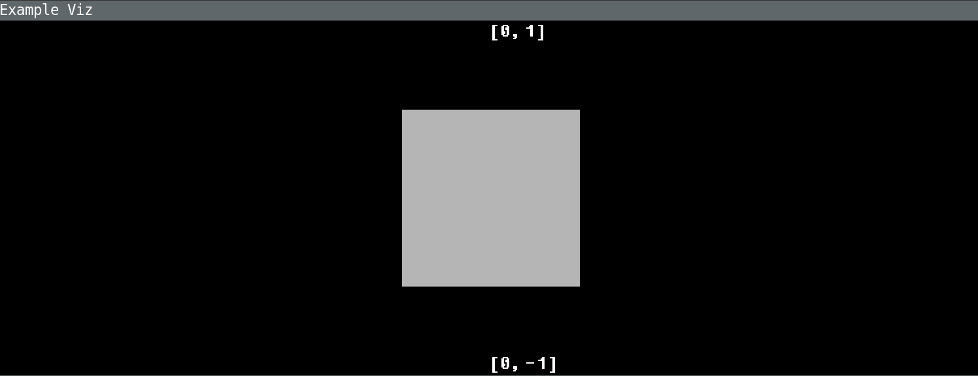
ous/src/ouster-ros/ouster-ros/ouster-sdk/docs/images/viz-tutorial/image_set_pos_center.png
