yufish87/LiDAR-based_Illegal_Parking_Detection_AMR/ous/src/ouster-ros/ouster-ros/ouster-sdk/docs/images/viz-tutorial/lidar_scan_viz.png

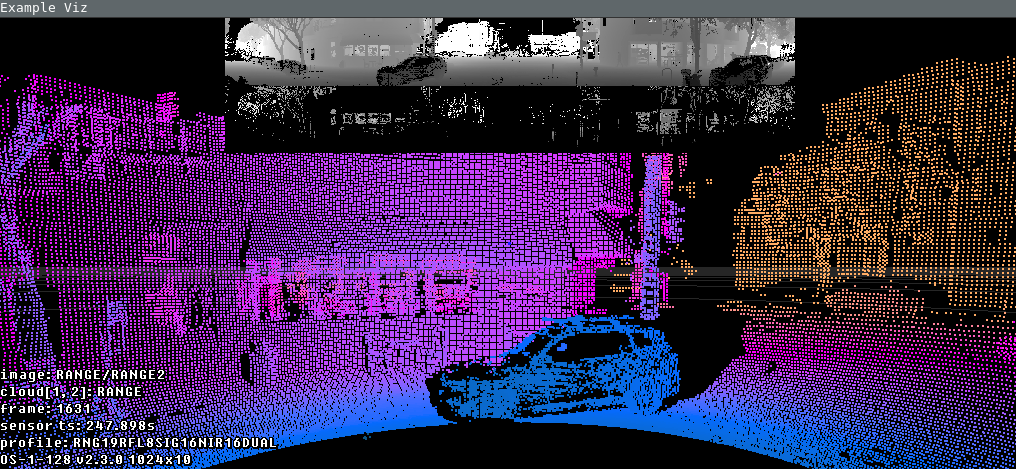
ous/src/ouster-ros/ouster-ros/ouster-sdk/docs/images/viz-tutorial/lidar_scan_viz.png
