yufish87/LiDAR-based_Illegal_Parking_Detection_AMR/ros2_ws/src/lidar_localization_ros2/param/localization.yaml

/**:
    ros__parameters:
      registration_method: "NDT_OMP"
      score_threshold: 2.0
      ndt_resolution: 1.0
      ndt_step_size: 0.1
      ndt_num_threads: 4
      ndt_max_iterations: 35
      gicp_corr_randomness: 20
      gicp_max_correspondence_distance: 2.0
      vgicp_voxel_resolution: 1.0
      transform_epsilon: 0.01
      voxel_leaf_size: 0.2
      scan_max_range: 100.0
      scan_min_range: 1.0
      scan_period: 0.1
      use_pcd_map: true
      map_path: "/home/ntust/final_map_V1_9_8_F_FLATTENED.pcd"
      set_initial_pose: true
      initial_pose_x: 0.0
      initial_pose_y: 0.0
      initial_pose_z: 0.0
      initial_pose_qx: 0.0
      initial_pose_qy: 0.0
      initial_pose_qz: 0.0
      initial_pose_qw: 0.0
      use_odom: false
      use_twist_prediction: false
      twist_prediction_use_angular_velocity: true
      max_twist_prediction_dt: 0.5
      use_imu: false
      use_imu_preintegration: true
      imu_preintegration_use_base_frame_transform: false
      imu_prediction_correction_guard_translation_m: 2.0
      imu_prediction_correction_guard_yaw_deg: 4.0
      enable_reinitialization_request_output: true
      enable_reinitialization_request_latch: true
      reinitialization_trigger_threshold: 0.95
      reinitialization_trigger_gap_scale_sec: 30.0
      reinitialization_trigger_seed_translation_scale_m: 100.0
      reinitialization_trigger_reject_streak_scale: 200.0
      reinitialization_trigger_fitness_explosion_threshold: 1000.0
      enable_debug: true
      predict_pose_from_previous_delta: true
      reject_above_score_threshold: true
      enable_map_odom_tf: false
      global_frame_id: map
      odom_frame_id: odom
      base_frame_id: base_link
      enable_timer_publishing: false
      pose_publish_frequency: 30.0
